milimithrandir/agent-pendant-easy-mvp/original/ideas.md

# Ideas

- **Agent of choice:** Easily connect the pendant to your agent of choice (Muse, Grok bot, Hermes Agent, OpenClaw, Claude Code — you name it).
