milimithrandir/agent-pendant-easy-mvp/images/cad_slim35_dot_pattern.png

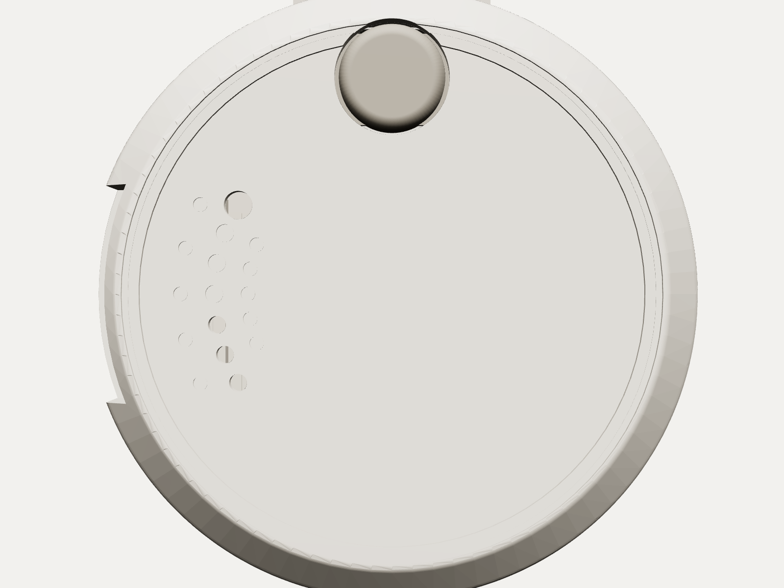
images/cad_slim35_dot_pattern.png
