milimithrandir/agent-pendant-easy-mvp/images/concept_24mm_hand_vs_1euro.jpg

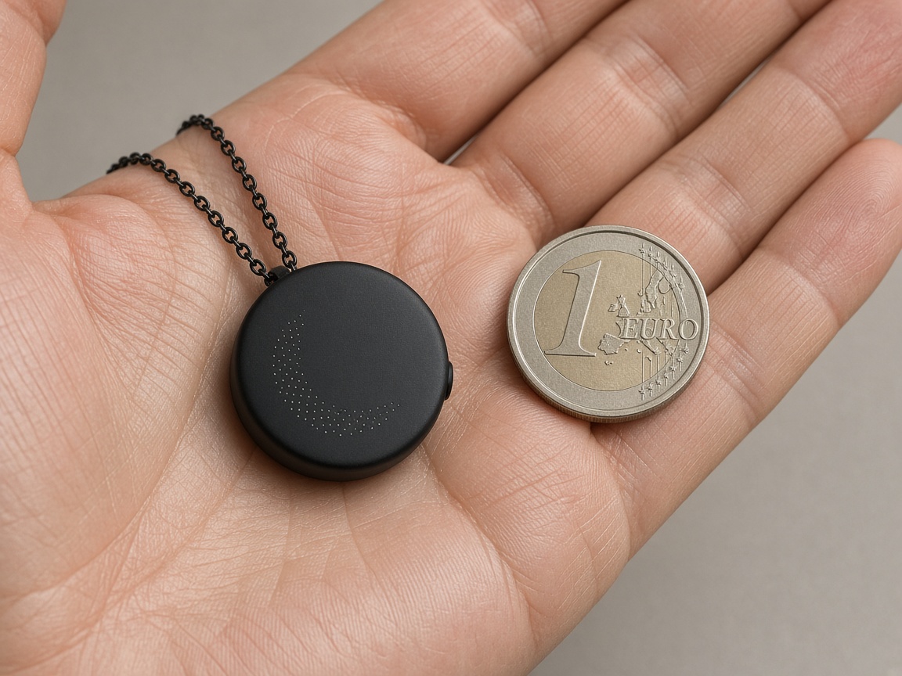
images/concept_24mm_hand_vs_1euro.jpg
