milimithrandir/agent-pendant-easy-mvp/images/concept_24mm_worn_man.jpg

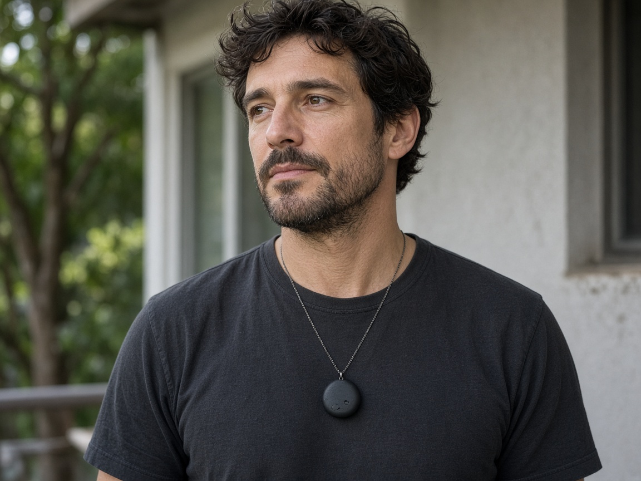
images/concept_24mm_worn_man.jpg
