milimithrandir/agent-pendant-easy-mvp/images/concept_28mm_hand_vs_2euro.jpg

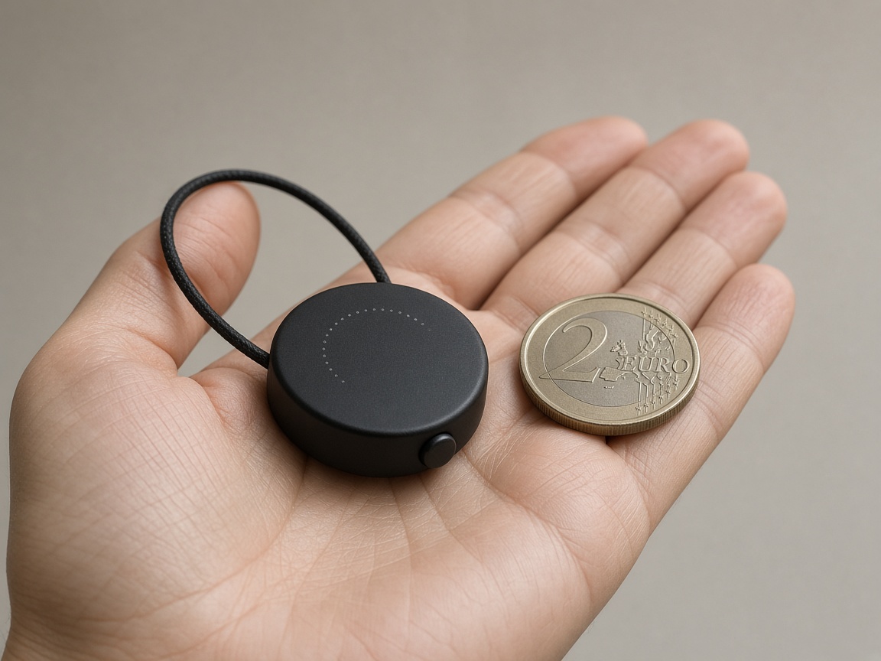
images/concept_28mm_hand_vs_2euro.jpg
