milimithrandir/agent-pendant-easy-mvp/images/concept_28mm_worn_man.jpg

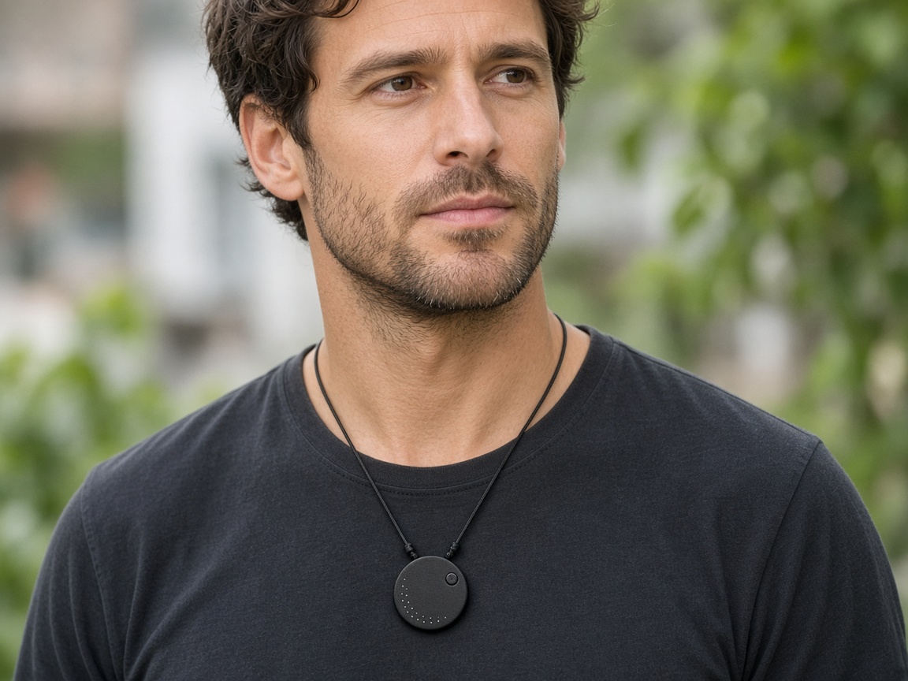
images/concept_28mm_worn_man.jpg
