milimithrandir/agent-pendant-easy-mvp/images/concept_30mm_worn_woman.jpg

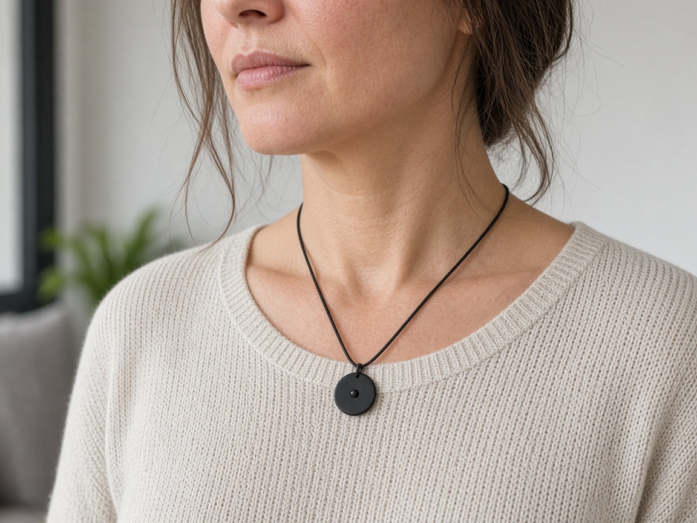
images/concept_30mm_worn_woman.jpg
