milimithrandir/agent-pendant-easy-mvp/docs/v2-custom-board/option2_bom.csv

ref | part | MPN | LCSC | qty_per_board | unit_price_usd_qty1-9 | jlc_type | jlc_stock_2026-10-26 | source_url
U1 | BLE module nRF52840 15.0x10.2x1.9 integrated antenna | BMD-340-A-R (u-blox) | C5456944 | 1 | 9.7435 | extended | 416 | https://www.lcsc.com/product-detail/C5456944.html
U2 | CO2 sensor 4x3x1.2 LGA | STCC4-D-R3 (Sensirion) | C49191471 | 1 | 12.5587 | extended | 1473 | https://www.lcsc.com/product-detail/C49191471.html
U3 | Temp/RH sensor on STCC4 SDA_C/SCL_C (0x44) | SHT40-AD1B-R2 (Sensirion) | C2909890 | 1 | 1.9167 | extended | 18521 | https://www.lcsc.com/product-detail/C2909890.html
MK1 | PDM MEMS mic top-port 4x3x1 | SPK0838HT4H-1 (Knowles) | C5447637 | 1 | 3.8611 | extended | 37 | https://www.lcsc.com/product-detail/C5447637.html
MK1-alt | PDM MEMS mic alternative (port side unverified) | IM69D130V01 (Infineon) | C536262 | 0 | 4.0853 | extended | 246 | https://www.lcsc.com/product-detail/C536262.html
U4 | LiPo charger (R_PROG 47k = 21 mA) | MCP73831T-2ACI/OT (Microchip) | C424093 | 1 | 0.7006 | extended | 6745 | https://www.lcsc.com/product-detail/C424093.html
U5 | LDO 3.3V 1uA Iq SOT-23 | XC6206P332MR-G (Torex) | C5446 | 1 | 0.1452 | basic | 445692 | https://www.lcsc.com/product-detail/C5446.html
Q1 | P-MOSFET mic power gated by PTT button | AO3401A | C15127 | 1 | 0.096 | basic | 709207 | https://www.lcsc.com/product-detail/C15127.html
SW1 | Push-to-talk tact switch 5.1x5.1x1.5 | TS-1187A-B-A-B (XKB) | C318884 | 1 | 0.0207 | basic | 1188048 | https://www.lcsc.com/product-detail/C318884.html
Y1 | 32.768 kHz crystal 12.5pF 3.2x1.5 | Q13FC13500004 (Epson FC-135) | C32346 | 1 | 0.1709 | basic | 489634 | https://www.lcsc.com/product-detail/C32346.html
D1 | ESD diode on VBUS pad SOD-523 | LESD5D5.0CT1G | C5274290 | 1 | 0.0152 | extended | 88901 | https://www.lcsc.com/product-detail/C5274290.html
LED1 | Indicator LED 0402 red | NCD0402R1 | C130719 | 1 | 0.0406 | extended | 533643 | https://www.lcsc.com/product-detail/C130719.html
C1-C4 | 100nF 0402 X7R decoupling | CL05B104KO5NNNC | C1525 | 4 | 0.0035 | basic | 34901882 | https://www.lcsc.com/product-detail/C1525.html
C5-C6 | 1uF 0402 X5R (LDO in/out) | CL05A105KA5NQNC | C52923 | 2 | 0.0063 | basic | 11303371 | https://www.lcsc.com/product-detail/C52923.html
C7-C9 | 4.7uF 0402 X5R (charger in/out + module) | CL05A475MP5NRNC | C23733 | 3 | 0.0153 | basic | 2605905 | https://www.lcsc.com/product-detail/C23733.html
C10 | 10uF 0402 X5R 3V3 bulk | CL05A106MQ5NUNC | C15525 | 1 | 0.0257 | basic | 10573519 | https://www.lcsc.com/product-detail/C15525.html
C11-C12 | 20pF 0402 C0G (32k crystal load) | 0402CG200J500NT | C1554 | 2 | 0.0026 | basic | 1161741 | https://www.lcsc.com/product-detail/C1554.html
R1 | 47k 0402 charger R_PROG (33k C25779 for 55 mAh cell) | 0402WGF4702TCE | C25792 | 1 | 0.002 | basic | 6637048 | https://www.lcsc.com/product-detail/C25792.html
R2-R3 | 1M 0402 VBAT divider | 0402WGF1004TCE | C26083 | 2 | 0.0015 | basic | 2293996 | https://www.lcsc.com/product-detail/C26083.html
R4-R6 | 100k 0402 (FET gate pull-up + VBUS divider) | 0402WGF1003TCE | C25741 | 3 | 0.0015 | basic | 7643996 | https://www.lcsc.com/product-detail/C25741.html
R7 | 1k 0402 LED | 0402WGF1001TCE | C11702 | 1 | 0.0013 | basic | 18873157 | https://www.lcsc.com/product-detail/C11702.html
R8-R9 | 10k 0402 I2C pull-ups (optional) | 0402WGF1002TCE | C25744 | 2 | 0.0024 | basic | 17613032 | https://www.lcsc.com/product-detail/C25744.html
BT1 | LiPo 40 mAh 20.5x10x3 with PCM (buy separately) | Electrokit 40mAh BEC | - | 1 | ~5 EUR (55 SEK) | not JLC | - | https://www.electrokit.com/en/battery-lipo-3.7v-40mah-bec
BT1-alt | LiPo 55 mAh 15x10x5 with PCM (buy separately) | Electrokit 55mAh | - | 0 | ~5 EUR (55 SEK) | not JLC | - | https://www.electrokit.com/en/batteri-lipo-3.7v-55mah
TOOL1 | SWD programmer + dev board (buy separately) | nRF52840-DK | - | 0 | 51.90 EUR net (TME FI) | not JLC | - | https://www.tme.eu/fi/details/nrf52840-dk/tiedonsiirtopaketit/nordic-semiconductor/
TOOL2 | Cheap SWD probe CMSIS-DAP (buy separately) | Raspberry Pi Debug Probe | - | 0 | 11.90 EUR incl 19% VAT | not JLC | - | https://www.welectron.com/Raspberry-Pi-Debug-Probe_1
