milimithrandir/agent-pendant-easy-mvp/(commit log)

2026-10-30 Easy MVP (v1): XIAO nRF52840 Sense + STCC4 order list (re-checked 2026-10-30), build guide, Step 0, v2 path, session log
    [ORDER_LIST.csv, option2_bom.csv, option2_bom_minimum.csv]
2026-10-30 Add VOICE_TO_GROK_BOT.md: routes into the assistant (webhook recommended), STT options, firmware audio format, staged plan; link from README and session log
2026-10-30 Prioritize direct Grok Bot shortcut and webhook over email relay
